dtantalidis2002/mage0rESPlant/Circuit/DXF/ESPlant-Edge.Cuts.dxf

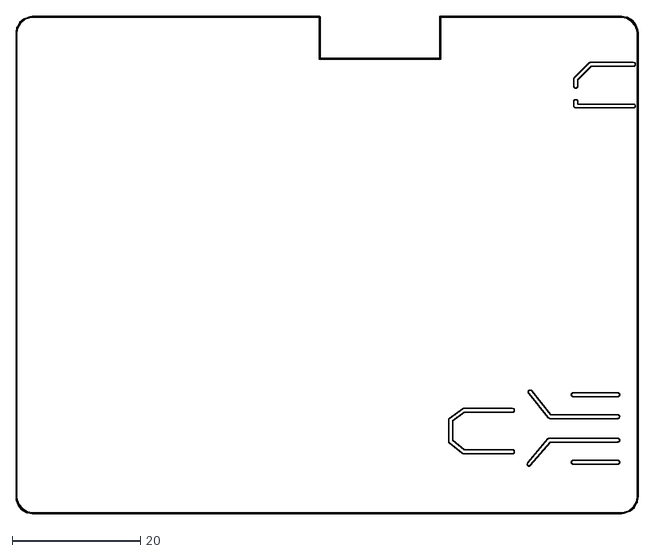
[picture p1: CAD file, 2018-03-14]
Circuit/DXF/ESPlant-Edge.Cuts.dxf
97.1 x 77.6
