dtantalidis2002/mage0rESPlant/(list of files, cad)

Other CAD files:
Circuit/DXF/ESPlant-F.SilkS.dxf
