dtantalidis2002/mage0rESPlant/Circuit/ESPlant.pdf

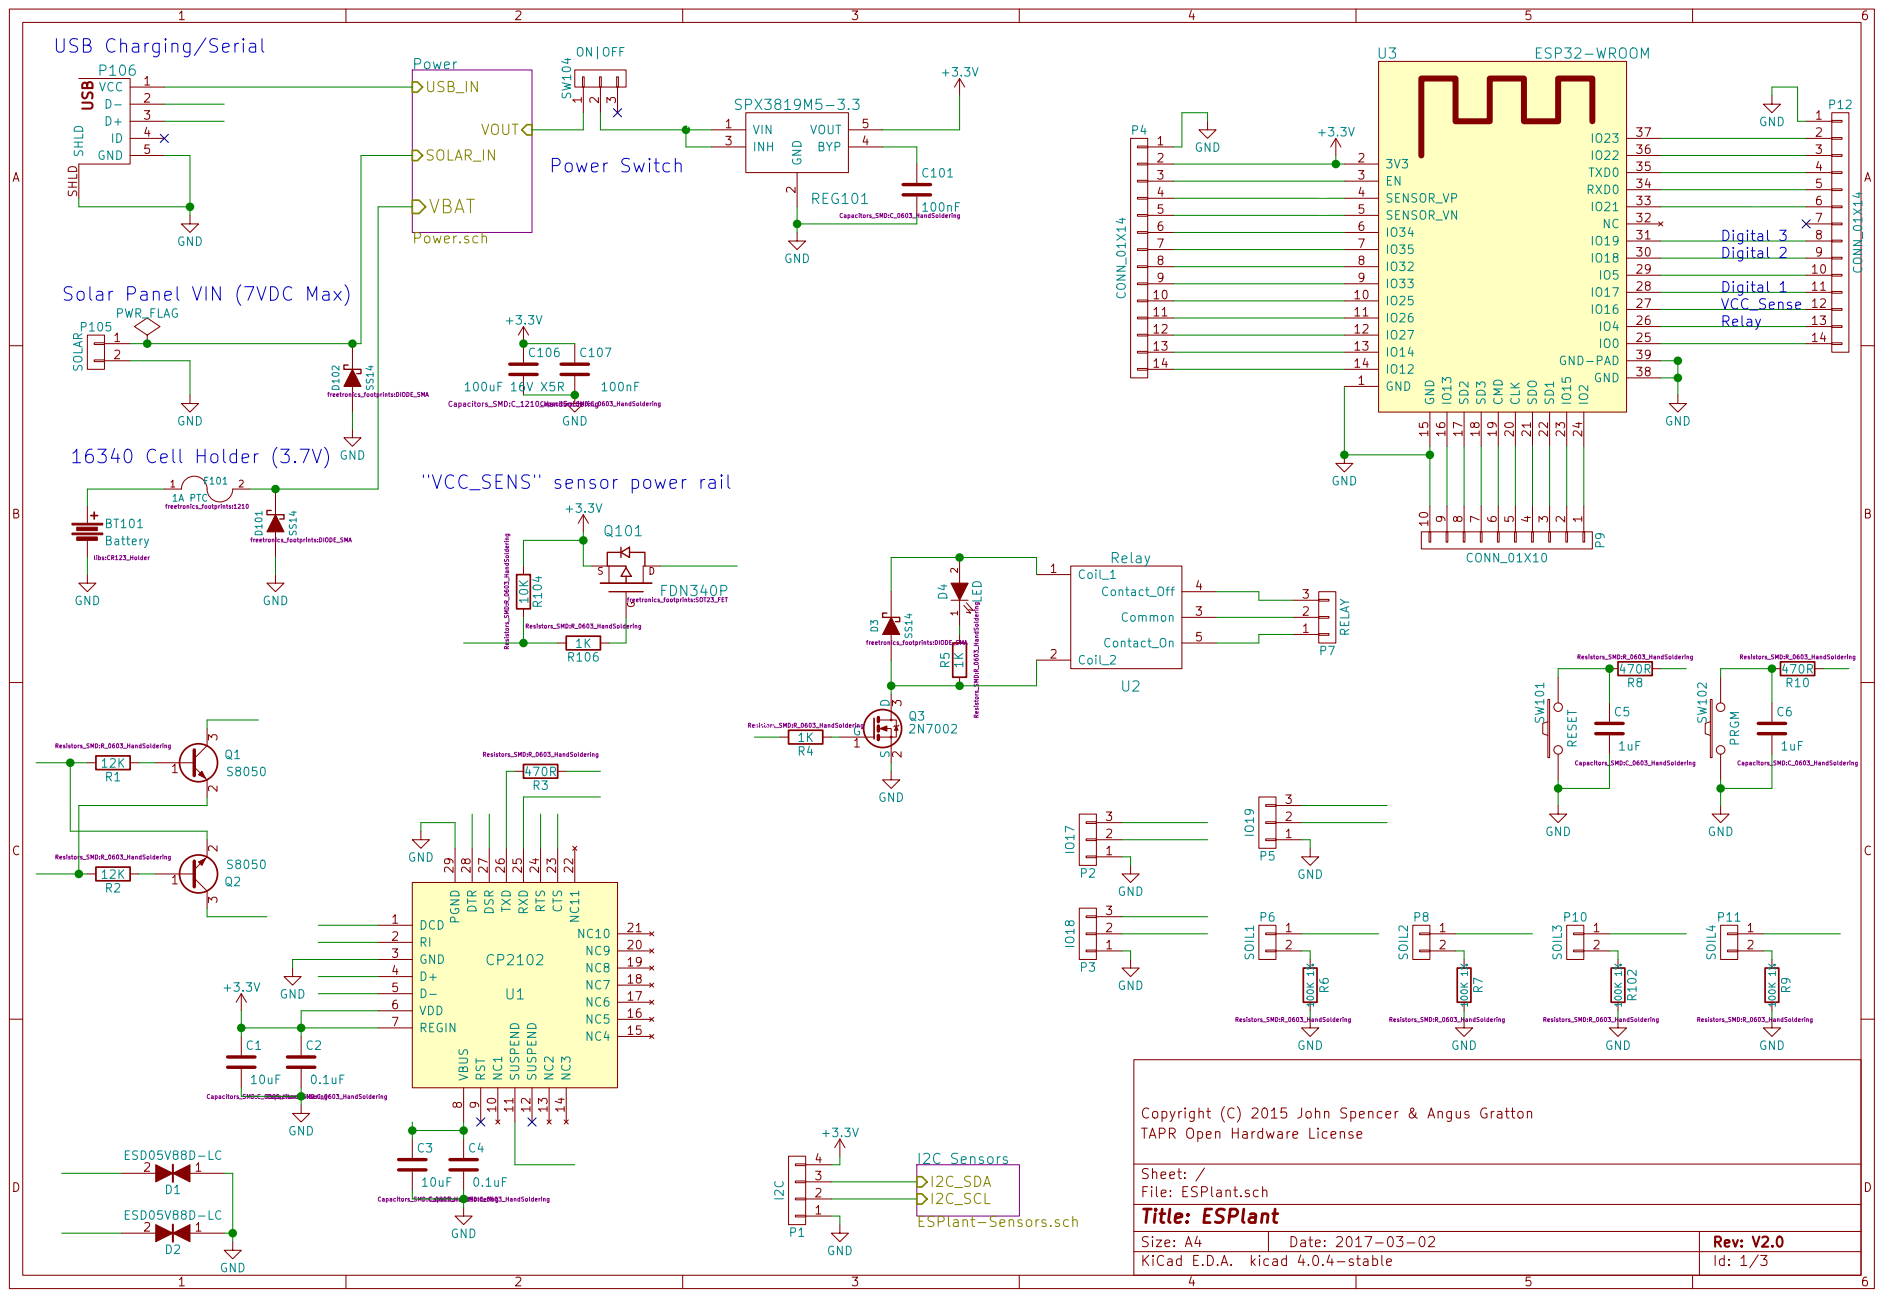
[picture p2: page 1]

SOLAR_IN VBAT

3 | EN | 3V3 2 EN 3 SENSOR_VP 4 SENSOR_VN 5

4 SOIL1 | Sensor_VP
SOIL2 5 | Sensor_VN
6 | IO34 | IO34 6
7 | IO35 | IO35 7

9 | IO33 | IO33 9
10 | IO25
11 | IO26
12 | IO27

Solar Panel VIN (7VDC Max) GND

ACTIVE RTS CTS RXD

9 NC1 10 NC9 20 SUSPEND 11 NC10 21 SUSPEND 12 NC11 22 NC2 13 CTS 23 NC3 14 RTS 24 NC4 15 RXD 25 NC5 16 TXD 26 NC6 17 DSR 27 NC7 18 DTR 28 NC8 19 PGND 29 U1 CP2102

Copyright (C) 2015 John Spencer & Angus Gratton | Resistors_SMD:R_0603_HandSoldering I2C_SDA

Id: 1/3 Title: ESPlant File: ESPlant.sch Sheet: / TAPR Open Hardware License

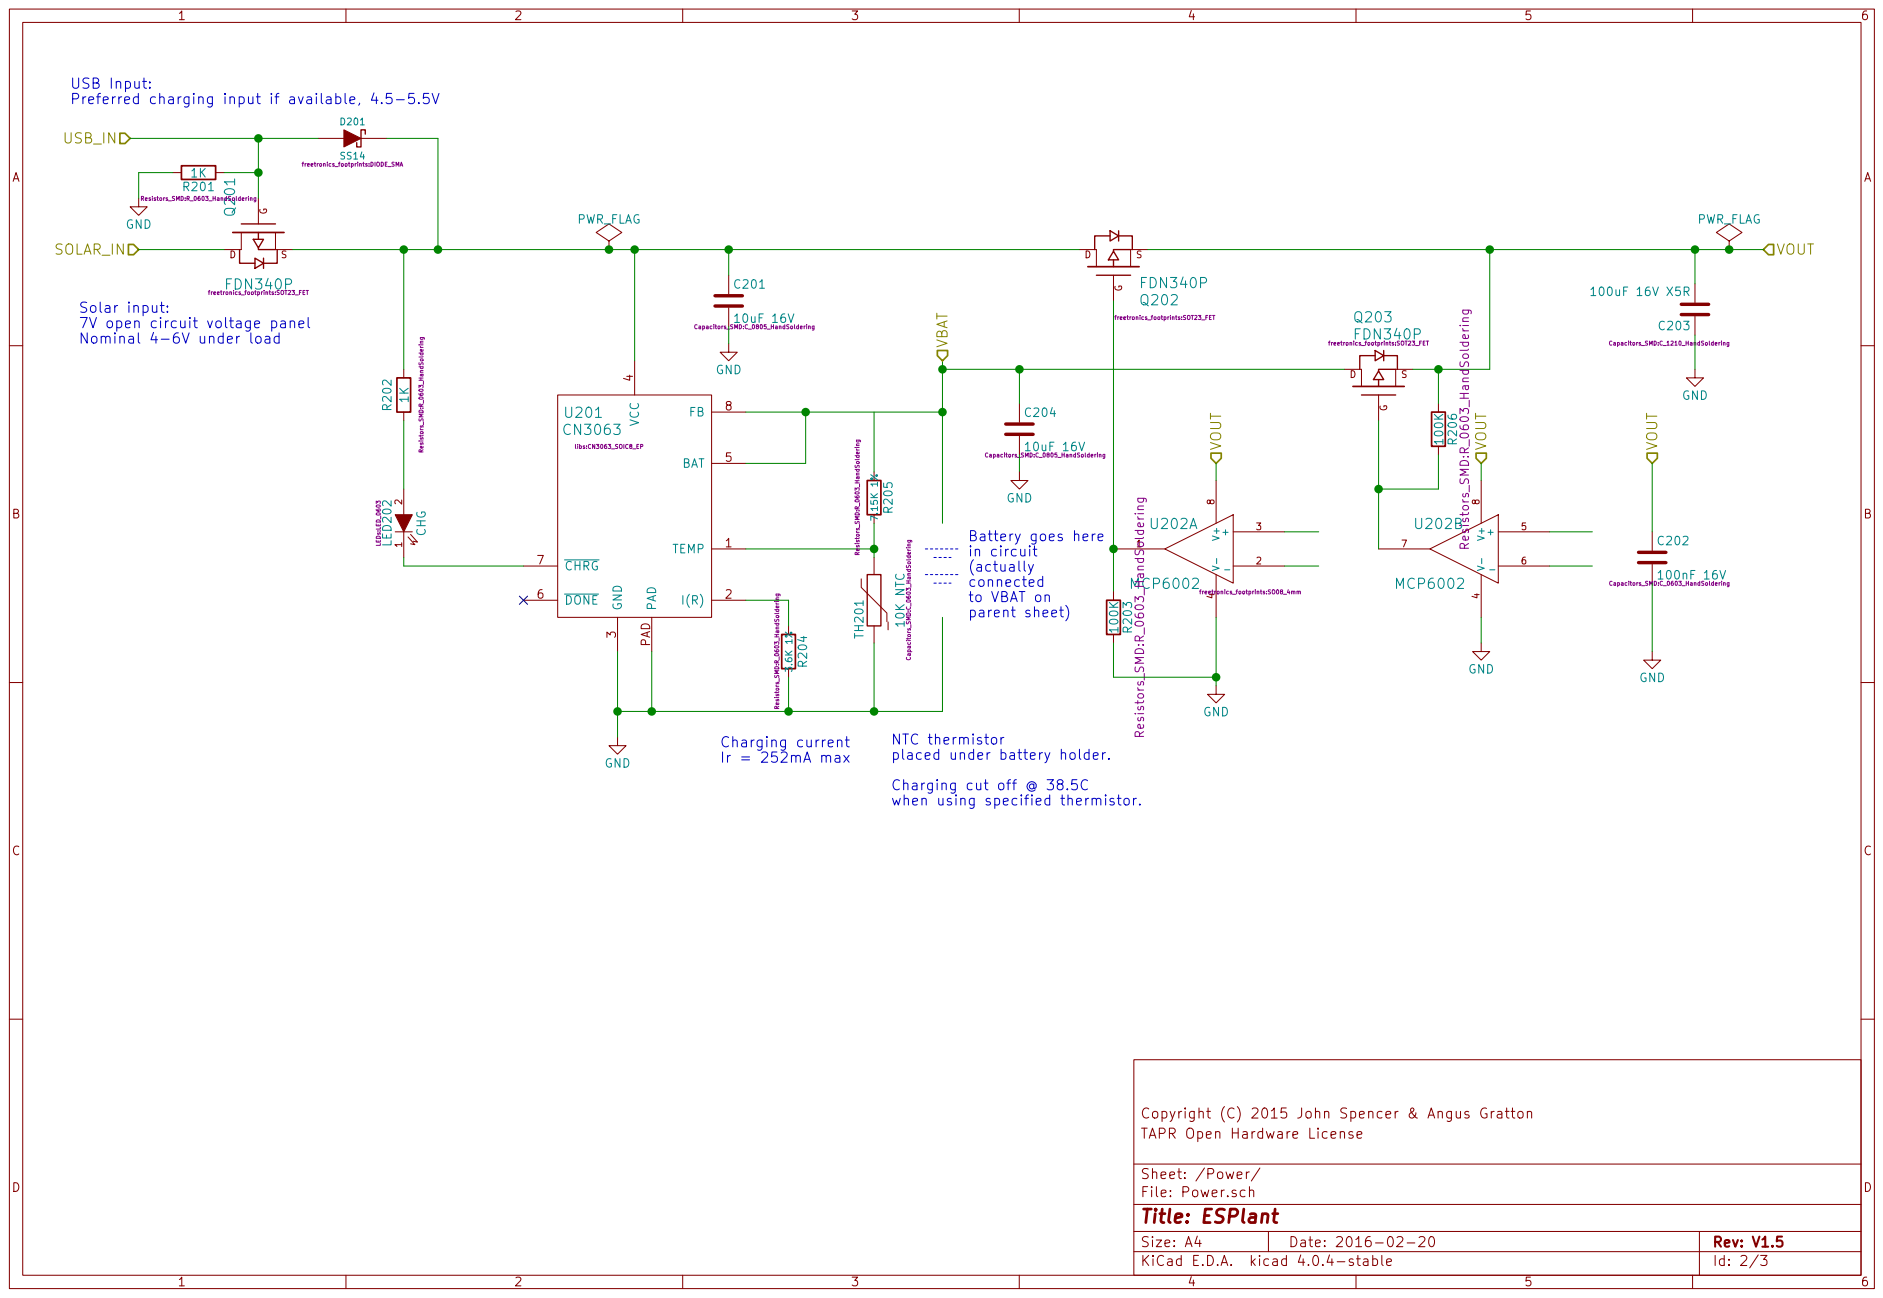
[picture p3: page 2]

freetronics_footprints:SOT23_FET USB Input:
Preferred charging input if available, 4.5-5.5V

when using specified thermistor. C204

4 BAT 5 DONE 6 CHRG 7 FB 8 PAD PAD U201 CN3063

8 U202B MCP6002 VOUT VOUT GND VBAT VBAT VIN

NTC thermistor placed under battery holder.

Copyright (C) 2015 John Spencer & Angus Gratton
Id: 2/3 Title: ESPlant File: Power.sch Sheet: /Power/ TAPR Open Hardware License

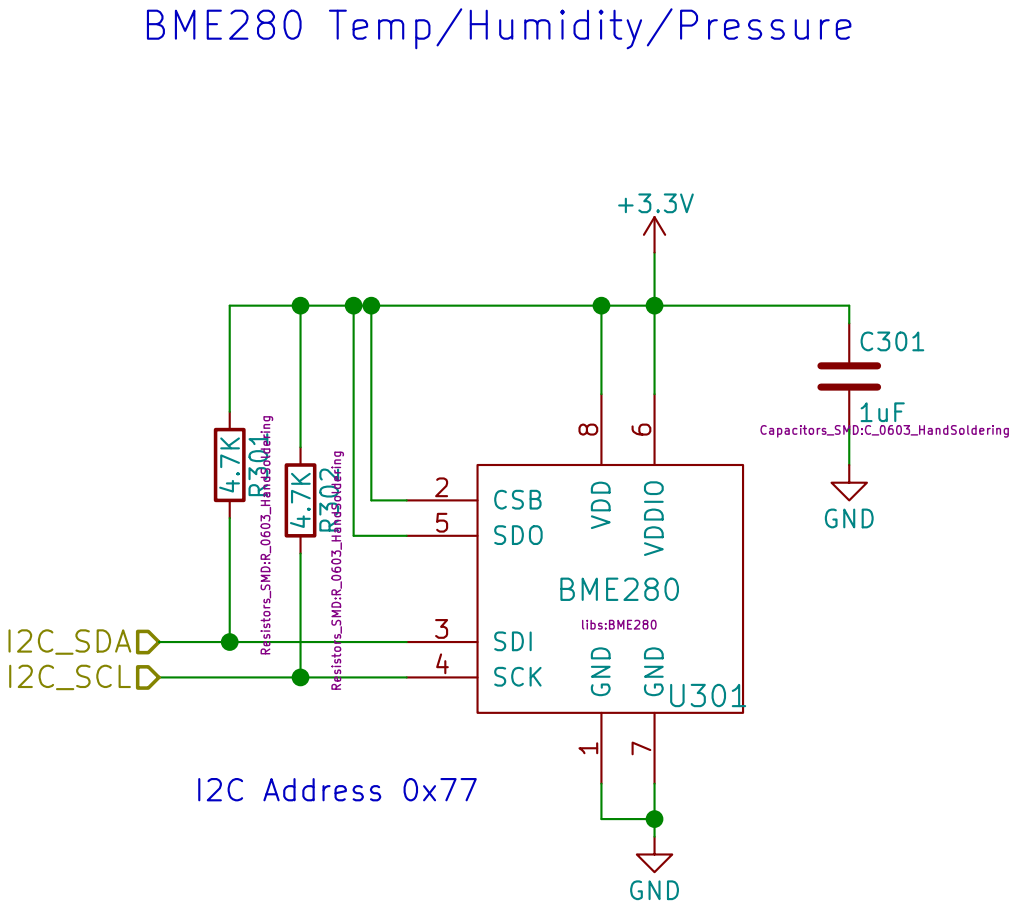
[picture p4: page 3]

1 CSB 2 SDI 3 SCK 4 SDO 5 VDDIO

Copyright (C) 2015 John Spencer & Angus Gratton GND

Id: 3/3 Title: ESPlant File: ESPlant-Sensors.sch Sheet: /I2C Sensors/ TAPR Open Hardware License
