dtantalidis2002/mage0rESPlant/Circuit/ESPlant.kicad_pcb

## KiCad design Circuit/ESPlant.kicad_pcb (2018-03-14)

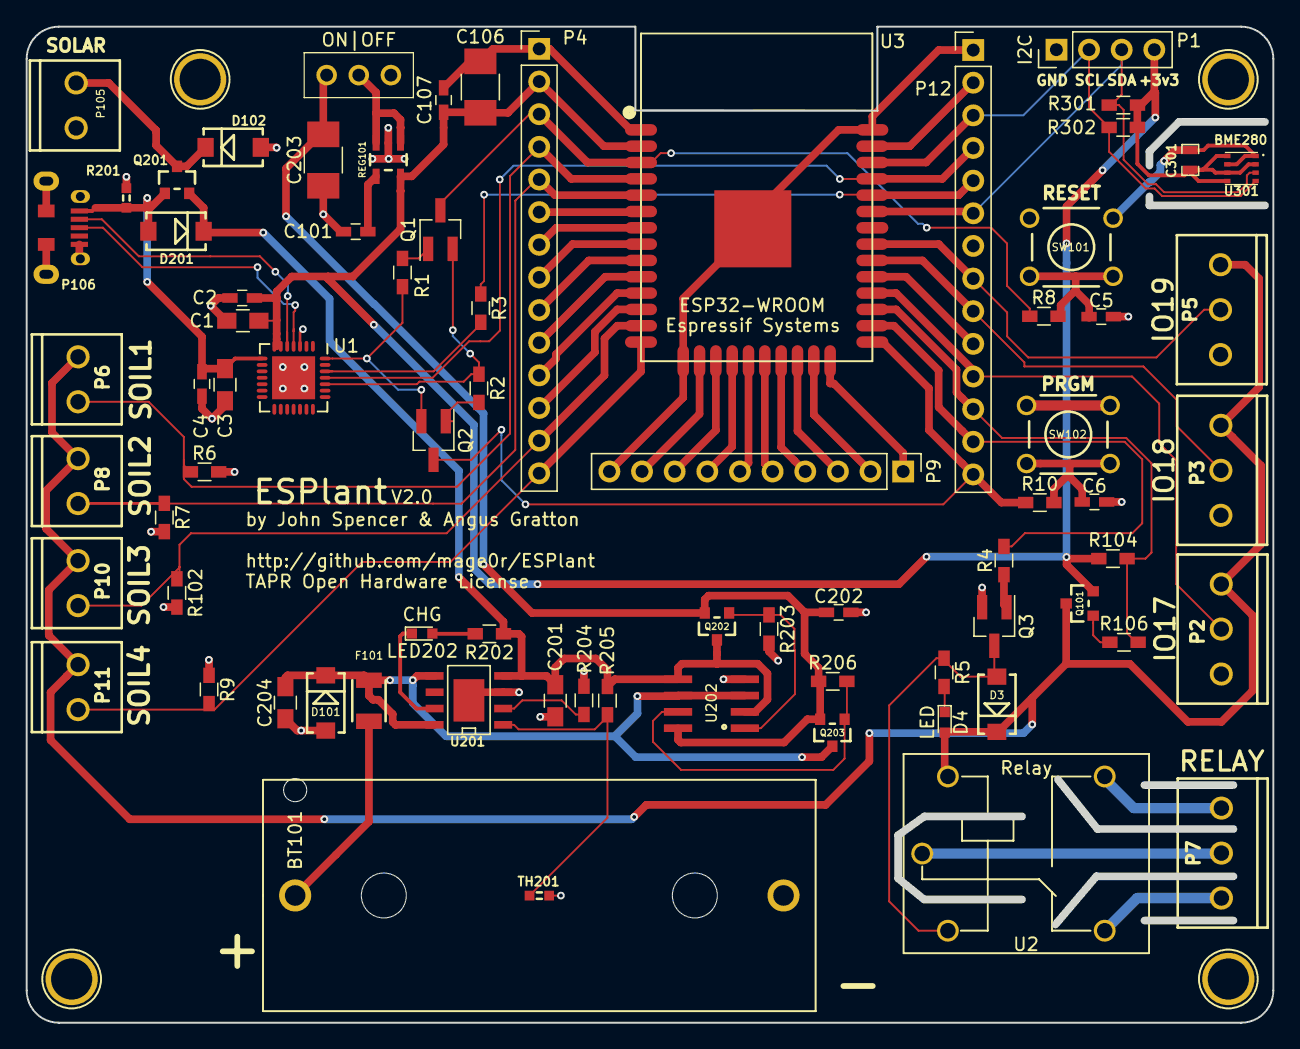
[picture p5: board ESPlant.kicad_pcb from above]

Board: 2 copper layers, 97.0 x 77.5 mm, 79 parts (0 on the bottom side), 66 nets.

Parts:
BT101: Battery; CR123_Holder
C1, C3, C201, C204: 10uF; C_0805_HandSoldering
C2, C4: 0.1uF; C_0603_HandSoldering
C5, C6: 1uF; C_0603_HandSoldering
C101, C107, C202: 100nF; C_0603_HandSoldering
C106: 100uF; C_1210_HandSoldering
C203: 100uF 16V X5R; C_1210_HandSoldering
C301: 1uF; 0603_CAP
D3, D101, D102, D201: SS14; DIODE_SMA
D4: LED; LED_0603
F101: 1A PTC; 1210
LED202: CHG; LED_0603
MH101, MH102, MH103, MH104: TEST_1P; 1pin
P1: I2C; Pin_Header_Straight_1x04_Pitch2.54mm
P2: IO17; SCREWTERMINAL-3.5MM-3
P3: IO18; SCREWTERMINAL-3.5MM-3
P4, P12: CONN_01X14; Pin_Header_Straight_1x14_Pitch2.54mm
P5: IO19; SCREWTERMINAL-3.5MM-3
P6: SOIL1; SCREWTERMINAL-3.5MM-2
P7: RELAY; SCREWTERMINAL-3.5MM-3
P8: SOIL2; SCREWTERMINAL-3.5MM-2
P9: CONN_01X10; Pin_Header_Straight_1x10_Pitch2.54mm
P10: SOIL3; SCREWTERMINAL-3.5MM-2
P11: SOIL4; SCREWTERMINAL-3.5MM-2
P105: SOLAR; SCREWTERMINAL-3.5MM-2
P106: USB_5PIN_SHELL; USB-MICRO-5pin_PTHMOUNT
Q1, Q2: S8050; SOT-23_Handsoldering
Q3: 2N7002; SOT-23_Handsoldering
Q101, Q201, Q202, Q203: FDN340P; SOT23_FET
R1, R2: 12K; R_0603_HandSoldering
R3, R8, R10: 470R; R_0603_HandSoldering
R4, R5, R106, R202: 1K; R_0603_HandSoldering
R6, R7, R9, R102, R203, R206: 100K; R_0603_HandSoldering
R104: 10K; R_0603_HandSoldering
R201: 1K; 0603
R204: 3.6K; R_0603_HandSoldering
R205: 7.15K; R_0603_HandSoldering
R301, R302: 4.7K; R_0603_HandSoldering
REG101: SPX3819M5-3.3; SOT23-5
SW101: RESET; SW_PUSHBUTTON_PTH
SW102: PRGM; SW_PUSHBUTTON_PTH
SW104: ON|OFF; SS12D00
TH201: 10K NTC; 0603
U1: CP2102; QFN-28-1EP_5x5mm_Pitch0.5mm
U2: Relay; SPDT_Songle_Relay
U3: ESP32-WROOM
U201: CN3063; CN3063_SOIC8_EP
U202: MCP6002; SO08_4mm
U301: BME280

Connections:
+3V3: C1.1, C2.1, C106.1, C107.1, C301.1, P1.4, P4.2, Q101.S, R104.1, R301.1, R302.1, REG101.5, U1.6, U1.7, U3.2, U301.2, U301.5, U301.6, U301.8
/BAT+: BT101.1, F101.1
/CLK: P9.5, U3.20
/CMD: P9.6, U3.19
/DTR: Q2.2, R1.2, U1.28
/EN: P4.3, Q1.3, R8.1, U3.3
/I2C_SCL: P1.2, P12.3, R302.2, U3.36, U301.4
/I2C_SDA: P1.3, P12.6, R301.2, U3.33, U301.3
/IO0: P12.14, Q2.3, R10.1, U3.25
/IO2: P9.1, U3.24
/IO4: P12.13, R4.2, U3.26
/IO5: P12.10, U3.29
/IO12: P4.14, P11.2, R9.1, U3.14
/IO13: P9.9, U3.16
/IO14: P4.13, P10.2, R102.1, U3.13
/IO15: P9.2, U3.23
/IO16: P12.12, R104.2, R106.2, U3.27
/IO17: P2.2, P12.11, U3.28
/IO18: P3.2, P12.9, U3.30
/IO19: P5.2, P12.8, U3.31
/IO23: P12.2, U3.37
/IO25: P4.10, U3.10
/IO26: P4.11, U3.11
/IO27: P4.12, U3.12
/IO32: P4.8, U3.8
/IO33: P4.9, U3.9
/IO34: P4.6, U3.6
/IO35: P4.7, U3.7
/Power/GBAT: Q203.G, R206.2, U202.7
/Power/GIN: Q202.G, R203.1, U202.1
/Power/SOLAR_IN: D102.K, P105.1, Q201.D
/Power/VBAT: C204.1, D101.K, F101.2, Q203.D, U201.5, U201.8, U202.3, U202.6
/Power/VIN: C201.1, D201.K, Q201.S, Q202.D, R202.1, R205.1, U201.4, U202.2, U202.5
/Power/~CHRG: LED202.1, U201.7
/RTS: Q1.2, R2.2, U1.24
/RXD: P12.4, U1.25, U3.35
/SD0: P9.4, U3.21
/SD1: P9.3, U3.22
/SD2: P9.8, U3.17
/SD3: P9.7, U3.18
/SOIL1: P4.4, P6.2, R6.1, U3.4
/SOIL2: P4.5, P8.2, R7.1, U3.5
/TXD: P12.5, R3.1, U3.34
/USB_D+: P106.3, U1.4
/USB_D-: P106.2, U1.5
/USB_VCC: C3.1, C4.1, D201.A, P106.1, Q201.G, R201.1, U1.8
/VCC_SENS: D3.K, D4.2, P2.3, P3.3, P5.3, P6.1, P8.1, P10.1, P11.1, Q101.D, U2.1
/VOUT: C202.1, C203.2, Q202.S, Q203.S, R206.1, SW104.1, U202.8
/VSWITCHED: REG101.1, REG101.3, SW104.2
GND: BT101.2, C1.2, C2.2, C3.2, C4.2, C5.2, C6.2, C101.2, C106.2, C107.2, C201.2, C202.2, C203.1, C204.2, C301.2, D101.A, D102.A, P1.1, P2.1, P3.1, P4.1, P5.1, P9.10, P12.1, P105.2, P106.5, P106.SHLD, Q3.2, R6.2, R7.2, R9.2, R102.2, R201.2, R203.2, R204.2, REG101.2, SW101.1, SW102.1, TH201.2, U1.3, U1.29, U3.1, U3.15, U3.38, U3.39, U201.3, U201.PAD, U202.4, U301.1, U301.7
unnamed: C5.1, R8.2, SW101.2
unnamed: C6.1, R10.2, SW102.2
unnamed: C101.1, REG101.4
unnamed: D3.A, Q3.3, R5.1, U2.2
unnamed: D4.1, R5.2
unnamed: LED202.2, R202.2
unnamed: P7.1, U2.5
unnamed: P7.2, U2.3
unnamed: P7.3, U2.4
unnamed: Q1.1, R1.1
unnamed: Q2.1, R2.1
unnamed: Q3.1, R4.1
unnamed: Q101.G, R106.1
unnamed: R3.2, U1.26
unnamed: R204.1, U201.2
unnamed: R205.2, TH201.1, U201.1
