dtantalidis2002/mage0rESPlant/(commit log)

2017-03-09 ESP32 Version
    [ESPlant-Sensors.sch, ESPlant.kicad_pcb, ESPlant.sch, Power.sch]
2017-03-14 Updated pcb.
    Completed a missing track.
    Added some ground plane to the regulator.
    Changed some silkscreen test.
    [ESPlant.kicad_pcb]
2018-03-14 Updates, I guess
    [ESPlant-Edge.Cuts.dxf, ESPlant-F.SilkS.dxf, ESPlant.kicad_pcb, ESPlant.sch]
